UBIEEE/micromouse_yabai/firmware/micromouse.ioc

Mcu.UserName=STM32WB55CGUx
PA0.GPIO_Label=ENCODER_RIGHT_A
PA0.Signal=S_TIM2_CH1
PA1.GPIO_Label=ENCODER_RIGHT_B
PA1.Signal=S_TIM2_CH2
PA11.Signal=USB_DM
PA12.Signal=USB_DP
PA13.Signal=SYS_JTMS-SWDIO
PA14.Signal=SYS_JTCK-SWCLK
PA15.GPIO_Label=BUTTON_2
PA15.Signal=GPXTI15
PA2.GPIO_Label=IR_FAR_RIGHT_COLLECT
PA2.Signal=ADCx_IN7
PA3.GPIO_Label=IR_MID_RIGHT_COLLECT
PA3.Signal=ADCx_IN8
PA4.GPIO_Label=IR_MID_LEFT_COLLECT
PA4.Signal=ADCx_IN9
PA5.GPIO_Label=IR_FAR_LEFT_COLLECT
PA5.Signal=ADCx_IN10
PA6.GPIO_Label=BUZZER
PA6.Signal=S_TIM16_CH1
PA7.GPIO_Label=MOTOR_LEFT
PA7.Signal=GPIO_Output
PA8.GPIO_Label=MOTOR_LEFT_DIR
PA8.Signal=GPIO_Output
PA9.GPIO_Label=MOTOR_RIGHT_DIR
PA9.Signal=GPIO_Output
PB0.GPIO_Label=IR_FAR_LEFT_EMIT
PB0.Signal=GPIO_Output
PB1.GPIO_Label=IR_MID_LEFT_EMIT
PB1.Signal=GPIO_Output
PB2.GPIO_Label=MOTOR_RIGHT
PB2.Signal=GPIO_Output
PB3.Signal=SYS_JTDO-SWO
PB4.GPIO_Label=IR_FAR_RIGHT_EMIT
PB4.Signal=GPIO_Output
PB5.GPIO_Label=ENCODER_LEFT_B
PB5.Signal=LPTIM1_IN1
PB6.GPIO_Label=IMU_INT1
PB6.Signal=GPXTI6
PB7.GPIO_Label=ENCODER_LEFT_A
PB7.Signal=LPTIM1_IN2
PB8.Signal=I2C1_SCL
PB9.Signal=I2C1_SDA
PC14-OSC32_IN.Signal=RCC_OSC32_IN
PC15-OSC32_OUT.Signal=RCC_OSC32_OUT
PE4.GPIO_Label=IR_MID_RIGHT_EMIT
PE4.Signal=GPIO_Output
PH3-BOOT0.GPIO_Label=BUTTON_1
PH3-BOOT0.Signal=GPXTI3
