UBIEEE/micromouse_yabai/firmware/Core/Inc/main.h

#define BUTTON_1_Pin GPIO_PIN_3
#define BUTTON_1_GPIO_Port GPIOH
#define BUTTON_1_EXTI_IRQn EXTI3_IRQn
#define ENCODER_RIGHT_A_Pin GPIO_PIN_0
#define ENCODER_RIGHT_A_GPIO_Port GPIOA
#define ENCODER_RIGHT_B_Pin GPIO_PIN_1
#define ENCODER_RIGHT_B_GPIO_Port GPIOA
#define IR_FAR_RIGHT_COLLECT_Pin GPIO_PIN_2
#define IR_FAR_RIGHT_COLLECT_GPIO_Port GPIOA
#define IR_MID_RIGHT_COLLECT_Pin GPIO_PIN_3
#define IR_MID_RIGHT_COLLECT_GPIO_Port GPIOA
#define IR_MID_LEFT_COLLECT_Pin GPIO_PIN_4
#define IR_MID_LEFT_COLLECT_GPIO_Port GPIOA
#define IR_FAR_LEFT_COLLECT_Pin GPIO_PIN_5
#define IR_FAR_LEFT_COLLECT_GPIO_Port GPIOA
#define BUZZER_Pin GPIO_PIN_6
#define BUZZER_GPIO_Port GPIOA
#define MOTOR_LEFT_Pin GPIO_PIN_7
#define MOTOR_LEFT_GPIO_Port GPIOA
#define MOTOR_LEFT_DIR_Pin GPIO_PIN_8
#define MOTOR_LEFT_DIR_GPIO_Port GPIOA
#define MOTOR_RIGHT_DIR_Pin GPIO_PIN_9
#define MOTOR_RIGHT_DIR_GPIO_Port GPIOA
#define MOTOR_RIGHT_Pin GPIO_PIN_2
#define MOTOR_RIGHT_GPIO_Port GPIOB
#define IR_FAR_LEFT_EMIT_Pin GPIO_PIN_0
#define IR_FAR_LEFT_EMIT_GPIO_Port GPIOB
#define IR_MID_LEFT_EMIT_Pin GPIO_PIN_1
#define IR_MID_LEFT_EMIT_GPIO_Port GPIOB
#define IR_MID_RIGHT_EMIT_Pin GPIO_PIN_4
#define IR_MID_RIGHT_EMIT_GPIO_Port GPIOE
#define BUTTON_2_Pin GPIO_PIN_15
#define BUTTON_2_GPIO_Port GPIOA
#define BUTTON_2_EXTI_IRQn EXTI15_10_IRQn
#define IR_FAR_RIGHT_EMIT_Pin GPIO_PIN_4
#define IR_FAR_RIGHT_EMIT_GPIO_Port GPIOB
#define ENCODER_LEFT_B_Pin GPIO_PIN_5
#define ENCODER_LEFT_B_GPIO_Port GPIOB
#define IMU_INT1_Pin GPIO_PIN_6
#define IMU_INT1_GPIO_Port GPIOB
#define IMU_INT1_EXTI_IRQn EXTI9_5_IRQn
#define ENCODER_LEFT_A_Pin GPIO_PIN_7
#define ENCODER_LEFT_A_GPIO_Port GPIOB
#define ROBOT_UPDATE_PERIOD_MS 20
#define ROBOT_UPDATE_PERIOD_S (ROBOT_UPDATE_PERIOD_MS / 1000.f)
#define ROBOT_SEND_FEEDBACK_PERIOD_MS 100
#define ROBOT_SEND_FEEDBACK_PERIOD_S (ROBOT_SEND_FEEDBACK_PERIOD_MS / 1000.f)
