UBIEEE/micromouse_yabai/firmware/Core/Src/Drive/imu.cpp

#include "Drive/imu.hpp"

#include "Basic/error_manager.hpp"
#include "custom_stm.h"
#include <climits>

using namespace drive;

//
// External variables.
//

extern I2C_HandleTypeDef hi2c1; // main.c

//
// Constants.
//

static constexpr float GYRO_VELOCITY_COMPENSATION = 1.2f;

static constexpr uint8_t IMU_ADDR = (0x68 << 1); // 7-bit address, so shift left
static constexpr uint8_t IMU_WHO_AM_I = 0x67;

static constexpr uint8_t REG_WHO_AM_I      = 0x75;
static constexpr uint8_t REG_PWR_MGMT0     = 0x1F;
static constexpr uint8_t REG_INT_CONFIG    = 0x06;
static constexpr uint8_t REG_INT_SOURCE0   = 0x2B;
static constexpr uint8_t REG_GYRO_CONFIG0  = 0x20;
static constexpr uint8_t REG_ACCEL_CONFIG0 = 0x21;

static constexpr uint8_t REG_ACCEL_DATA_X1 = 0x0B;
static constexpr uint8_t REG_ACCEL_DATA_X0 = 0x0C;
static constexpr uint8_t REG_ACCEL_DATA_Y1 = 0x0D;
static constexpr uint8_t REG_ACCEL_DATA_Y0 = 0x0E;
static constexpr uint8_t REG_ACCEL_DATA_Z1 = 0x0F;
static constexpr uint8_t REG_ACCEL_DATA_Z0 = 0x10;

static constexpr uint8_t REG_GYRO_DATA_X1 = 0x11;
static constexpr uint8_t REG_GYRO_DATA_X0 = 0x12;
static constexpr uint8_t REG_GYRO_DATA_Y1 = 0x13;
static constexpr uint8_t REG_GYRO_DATA_Y0 = 0x14;
static constexpr uint8_t REG_GYRO_DATA_Z1 = 0x15;
static constexpr uint8_t REG_GYRO_DATA_Z0 = 0x16;

static constexpr uint32_t I2C_TIMEOUT = 100;

//
// IMU Functions.
//

void IMU::init(const Config& config) {
  if (m_init) return;

  m_config = config;

  const auto fail_if = [](bool condition) {
    if (condition) {
      ErrorManager::get().fatal_error(Error::IMU_CONFIG_FAIL);
    }
  };

  HAL_StatusTypeDef status;
  uint8_t buf[1];

  // Check WHO_AM_I register to verify I2C communication.
  status = read_register(REG_WHO_AM_I, buf, 1);
  fail_if(HAL_OK != status);
  fail_if(IMU_WHO_AM_I != buf[0]);

  const Config::Gyro& gyro_config           = m_config.gyro;
  const Config::Accelerometer& accel_config = m_config.accel;

  // Configure gyro range and sample rate.

  const uint8_t gyro_range       = uint8_t(gyro_config.range);
  const uint8_t gyro_sample_rate = uint8_t(gyro_config.sample_rate);

  buf[0] = gyro_range | gyro_sample_rate;
  status = write_register(REG_GYRO_CONFIG0, buf[0]);
  fail_if(HAL_OK != status);

  // Configure accelerometer range and sample rate.

  const uint8_t accel_range       = uint8_t(accel_config.range);
  const uint8_t accel_sample_rate = uint8_t(accel_config.sample_rate);

  buf[0] = accel_range | accel_sample_rate;
  status = write_register(REG_ACCEL_CONFIG0, buf[0]);
  fail_if(HAL_OK != status);

  // Configure INT1.

  // Data Ready interrupt routed to INT1 (Page 63).
  buf[0] = 0b00001000;
  status = write_register(REG_INT_SOURCE0, buf[0]);
  fail_if(HAL_OK != status);

  // Set INT1 drive circuit to push-pull (Page 50).
  buf[0] = 0b00000010;
  status = write_register(REG_INT_CONFIG, buf[0]);
  fail_if(HAL_OK != status);

  // Default to standby mode.

  set_standby_mode(true);

  m_init = true;
}

void IMU::set_standby_mode(bool on_standby) {
  using GyroMode  = Config::Gyro::Mode;
  using AccelMode = Config::Accelerometer::Mode;

  if (m_standby == on_standby) return;
  m_standby = on_standby;

  HAL_StatusTypeDef status;

  GyroMode gyro_mode;
  AccelMode accel_mode;

  if (on_standby) {
    gyro_mode  = GyroMode::STANDBY;
    accel_mode = AccelMode::STANDBY;
  } else {
    gyro_mode  = m_config.gyro.mode;
    accel_mode = m_config.accel.mode;
  }

  const uint8_t value = uint8_t(gyro_mode) | uint8_t(accel_mode);

  status = write_register(REG_PWR_MGMT0, value);
  UNUSED(status);
}

HAL_StatusTypeDef IMU::write_register(uint8_t reg, uint8_t value) {
  uint8_t data[2] = {reg, value};

  return HAL_I2C_Master_Transmit(&hi2c1, IMU_ADDR, data, 2, I2C_TIMEOUT);
}

HAL_StatusTypeDef IMU::read_register(uint8_t reg, uint8_t* buf, uint8_t len) {
  assert_param(len > 0);
  assert_param(buf != nullptr);

  HAL_StatusTypeDef status;

  // Write register address.
  status = HAL_I2C_Master_Transmit(&hi2c1, IMU_ADDR, &reg, 1, I2C_TIMEOUT);
  if (status != HAL_OK) return status;

  // Read data.
  status = HAL_I2C_Master_Receive(&hi2c1, IMU_ADDR, buf, len, I2C_TIMEOUT);
  return status;
}

void IMU::int1_handler() {
  if (!m_init || m_is_receiving) return;

  HAL_StatusTypeDef status;

  uint8_t buf[1] = {REG_ACCEL_DATA_X1};

  // Write register address.
  status = HAL_I2C_Master_Transmit(&hi2c1, IMU_ADDR, buf, 1, I2C_TIMEOUT);
  if (status != HAL_OK) return;

  // Read data.
  status = HAL_I2C_Master_Receive_DMA(&hi2c1, IMU_ADDR, m_data_raw, 12);
  if (status != HAL_OK) return;

  m_is_receiving = true;
}

void IMU::read_complete_handler() {
  if (!m_init || !m_is_receiving) return;

  const float accel_conversion = [&] {
    switch (m_config.accel.range) {
    case Config::Accelerometer::Range::_2_G:
      return (2.f / INT16_MAX);
    case Config::Accelerometer::Range::_4_G:
      return (4.f / INT16_MAX);
    case Config::Accelerometer::Range::_8_G:
      return (8.f / INT16_MAX);
    case Config::Accelerometer::Range::_16_G:
    default:
      return (16.f / INT16_MAX);
    }
  }();

  const int16_t accel_x = (m_data_raw[0] << 8) | m_data_raw[1];
  const int16_t accel_y = (m_data_raw[2] << 8) | m_data_raw[3];
  const int16_t accel_z = (m_data_raw[4] << 8) | m_data_raw[5];

  m_data.accel_data_g[Axis::X] = accel_x * accel_conversion;
  m_data.accel_data_g[Axis::Y] = accel_y * accel_conversion;
  m_data.accel_data_g[Axis::Z] = accel_z * accel_conversion;

  const float gyro_conversion = [&] {
    switch (m_config.gyro.range) {
    case Config::Gyro::Range::_250_DPS:
      return (250.f / INT16_MAX);
    case Config::Gyro::Range::_500_DPS:
      return (500.f / INT16_MAX);
    case Config::Gyro::Range::_1000_DPS:
      return (1000.f / INT16_MAX);
    case Config::Gyro::Range::_2000_DPS:
    default:
      return (2000.f / INT16_MAX);
    }
  }();

  const int16_t gyro_x = (m_data_raw[6] << 8) | m_data_raw[7];
  const int16_t gyro_y = (m_data_raw[8] << 8) | m_data_raw[9];
  const int16_t gyro_z = (m_data_raw[10] << 8) | m_data_raw[11];

  m_data.gyro_data_dps[Axis::X] = gyro_x * gyro_conversion;
  m_data.gyro_data_dps[Axis::Y] = gyro_y * gyro_conversion;
  m_data.gyro_data_dps[Axis::Z] = gyro_z * gyro_conversion;

  m_is_receiving = false;
}

void IMU::send_readings() {
  static_assert(sizeof(m_data) == 6 * 4);

  Custom_STM_App_Update_Char(CUSTOM_STM_DRIVE_IMUDATA_CHAR,
                             reinterpret_cast<uint8_t*>(&m_data));
}

#include "Basic/robot.hpp"

// I2C DMA interrupt callback.
void HAL_I2C_MasterRxCpltCallback(I2C_HandleTypeDef* hi2c) {
  assert_param(hi2c != nullptr);
  assert_param(hi2c == &hi2c1);
  UNUSED(hi2c);

  Robot::get().drive().imu().read_complete_handler();
}
