UBIEEE/micromouse_yabai/(commit log)

2024-04-16 Added KiCAD Schematic and PCB design
    [micromouse.kicad_pcb, micromouse.kicad_sch]
2024-04-17 Created firmware project with STM32CubeMX
2024-04-18 Rearranged MCU pins in schematic and PCB
    [micromouse.kicad_pcb, micromouse.kicad_sch]
2024-04-18 Rearranged MCU pins in STM32CubeMX
2024-04-20 Cleaned up PCB
    [micromouse.kicad_pcb, micromouse.kicad_sch]
2024-04-23 Cleaned up PCB, added tooling holes, etc.
    [micromouse.kicad_pcb, micromouse.kicad_sch]
2024-04-23 Rearranged PCB components, added extra mounting holes, removed encoder cutouts, etc.
    [micromouse.kicad_pcb]
2024-04-29 Final PCB adjustments
    [micromouse.kicad_pcb, micromouse.kicad_sch]
2024-04-30 Added clock model to PCB
    [micromouse.kicad_pcb]
2024-04-30 Updated pin assignments in CubeMX
2024-06-13 Got buttons working with external interrupts
2024-06-14 Calculated encoder distance and velocity
2024-06-17 Set up music service and characteristics, fixed some stuff in buzzer class, etc.
    [micromouse.ioc]
2024-06-18 Fixed buzzer quiet function to not crash when called from an interrupt
2024-06-25 Created PID controller class
2024-06-25 Some fixes to encoder counting, started adding pid controllers to drive class, etc.
    [drive.cpp, drive.hpp]
2024-06-28 Created ICM-42670-P driver class
2024-06-29 Updated IMU driver to use DMA
2024-06-29 Added error code notify characteristic to main service
    [micromouse.ioc]
2024-06-29 Cleaned up IMU driver class
2024-06-30 Added characteristics for IMU feedback, send gyro and acceleration data, etc.
2024-06-30 Worked on IMU page
2024-06-30 Added angle data to IMU page
2024-06-30 Differentiated IMU readings to produce angle, sent data over BLE
2024-07-01 Created encoder class and fixed velocity calculation
    [drive.cpp, drive.hpp, encoder.cpp, encoder.hpp]
2024-07-02 Changed update period and made encoders simpler
2024-07-07 Worked on adding drive velocity control, fixed encoder things, etc.
    [drive.cpp, drive.hpp, encoder.cpp, main.h]
2024-07-08 Updated main page to add test drive task and stop button
2024-07-08 Updated IMU driver to easier change configuration
2024-07-08 Updated gyro data characteristic size
2024-07-08 Updated gyro data characteristic size, removed angle section from IMU page
2024-07-09 Changed IMU data characteristic, added characteristic for drive PID constants, changed some task stuff, etc.
2024-07-09 Cleaned up several pages, adjusted IMU data characteristic and added page to edit PID constants, etc.
2024-07-15 Improved drivetrain control modes and PID control method, etc.
2024-07-30 Created odometry class
2024-07-30 Created timer class
2024-07-30 Lots of drive class updates, added odometry to app feedback, etc.
2024-07-30 Added odometry to drive page
2024-08-02 Robot control stuff including buttons, reset between tasks, etc.
2024-08-02 Improved IMU standby setting
2024-08-09 Moved more to navigation library, started reworking drive class, added starting position to app, etc.
    [constants.hpp, drive.cpp, drive.hpp, drive_controller.cpp, drive_controller.hpp]
2024-09-01 Added fatal error to error manager for unreachable code
    [imu.cpp]
2024-09-02 Drive rotational PID constants
2024-09-02 Calculated distance to objects with vision sensors
2024-09-02 Implemented the ability to arm tasks and trigger them using vision sensors
2024-09-03 Removed mysterious zero from PID constant
    How did that get there?!?!
2024-09-03 Added back function call to send IMU feedback
2024-09-03 Slowed down IMU sample rate because we don't need it very high
2024-09-05 Updated vision ADC reading to 10-bit
2024-09-05 Adjusted vision readings based on angle of IR sensors
