UBIEEE/micromouse_yabai/(notices)

Notices in the files:
firmware/Core/Inc/app_conf.h:
Copyright (c) 2024 STMicroelectronics.
All rights reserved.
This software is licensed under terms that can be found in the LICENSE file
